quentin-z80/iso-usb2pwrd/README.md

# iso-usb2pwrd

USB-C 2.0 Isolator with 1W Power passthrough

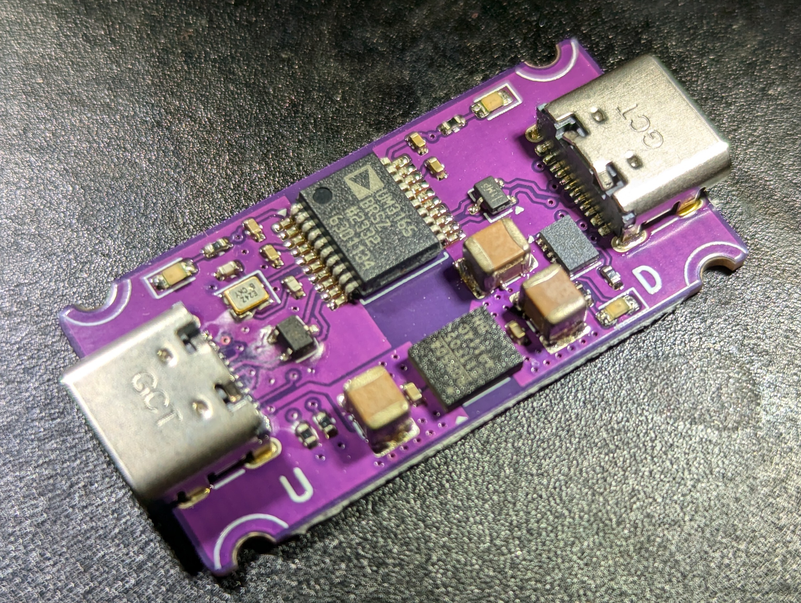
[picture p1: img/front.jpg]


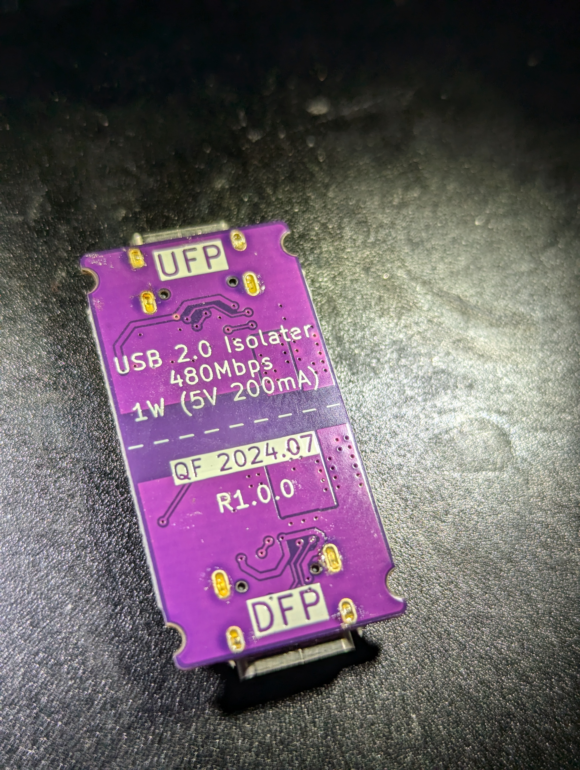
[picture p2: img/back.jpg]
