quentin-z80/iso-usb2pwrd/iso-usb2pwrd.pdf

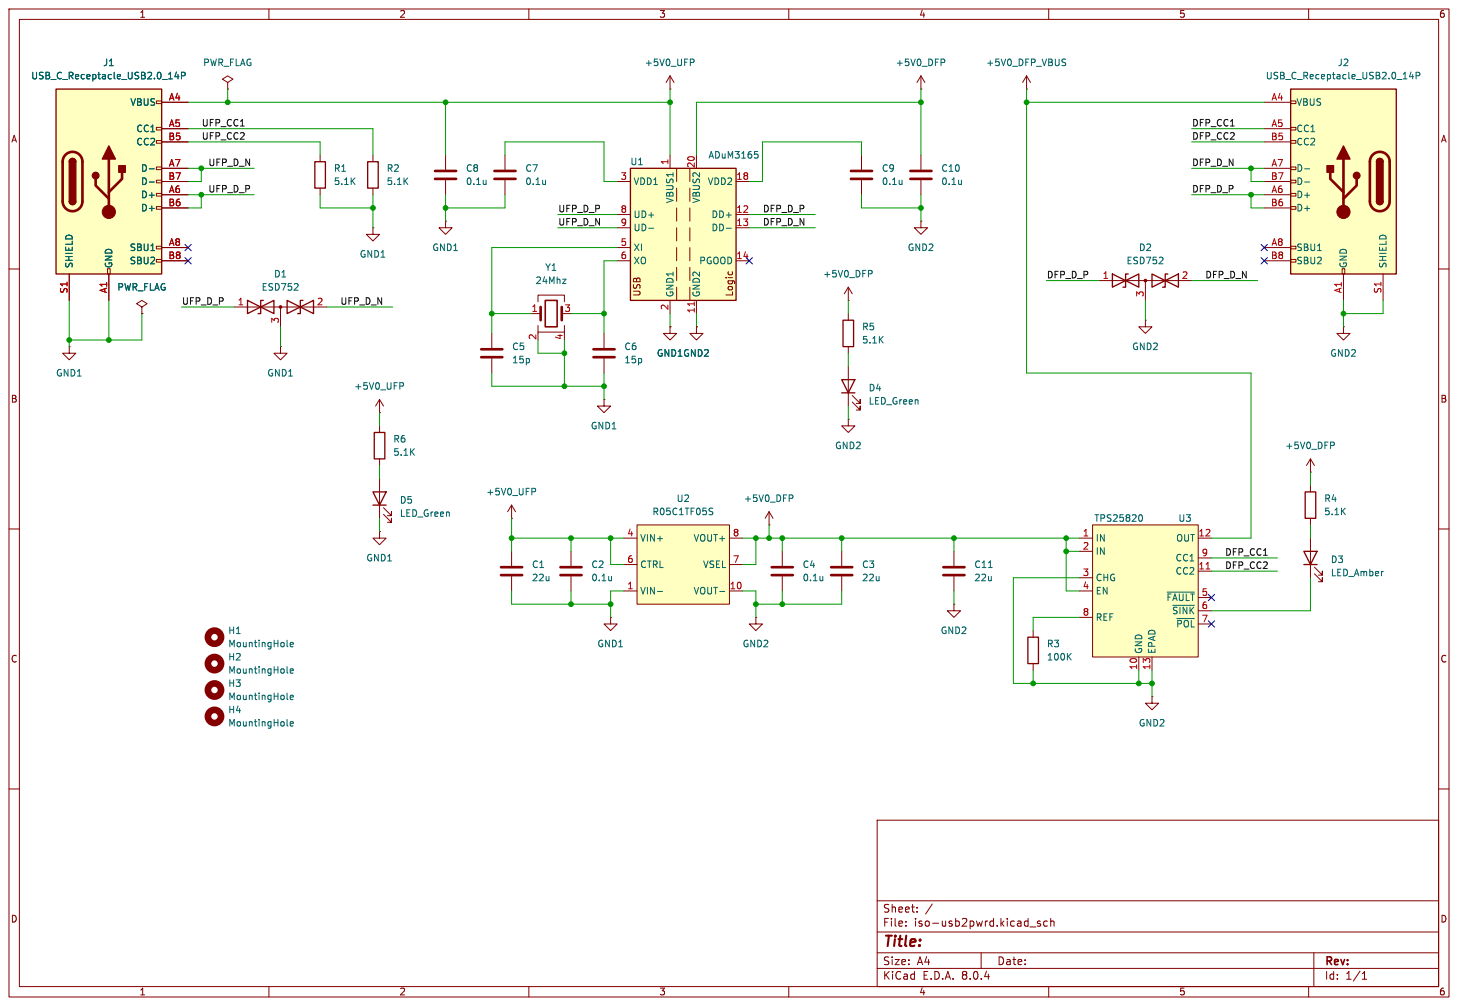
[picture p3: page 1]

2 VBUS2 20 VDD1 3 XI 5 XO 6 UD+ 8 UD- 9 U1 ADuM3165 GND1 C2

Id: 1/1 Title: File: iso-usb2pwrd.kicad_sch Sheet: /
