quentin-z80/iso-usb2pwrd/iso-usb2pwrd.kicad_pcb

## KiCad design iso-usb2pwrd.kicad_pcb (2024-07-22)

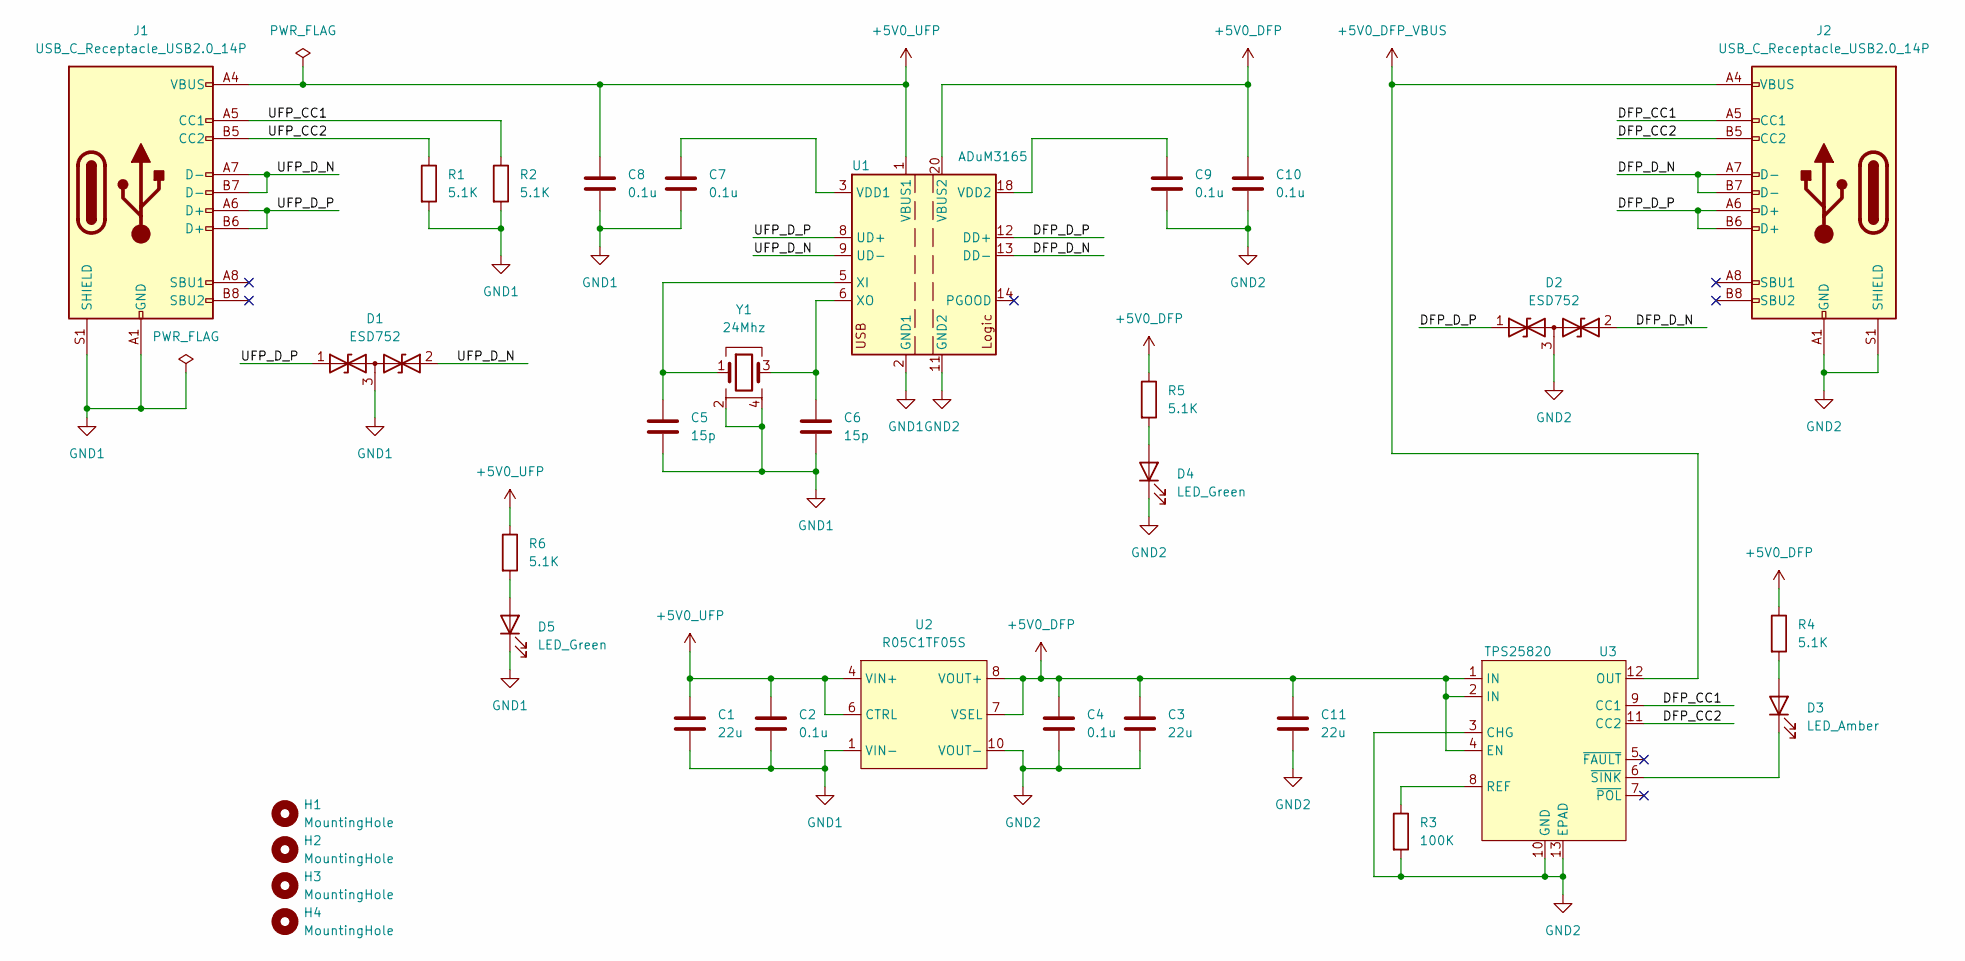
[picture p4: schematic iso-usb2pwrd.kicad_sch]

Parts:
C1, C3, C11: 22u; C_1210_3225Metric; MPN CL32B226MOJNNNE
C2, C4, C7, C8, C9, C10: 0.1u; C_0402_1005Metric; MPN GCM155R71H104KE02D
C5, C6: 15p; C_0402_1005Metric; MPN 0402N150J250CT
D1, D2: ESD752; SOT-323_SC-70; MPN ESD752DCKR
D3: LED_Amber; LED_0603_1608Metric; MPN SML-D12D1WT86
D4, D5: LED_Green; LED_0603_1608Metric; MPN SML-D12M8WT86
H1, H2, H3, H4: MountingHole; MountingHole_2.2mm_M2
J1, J2: USB_C_Receptacle_USB2.0_14P; USB_C_Receptacle_GCT_USB4105-xx-A_16P_TopMnt_Horizontal; MPN USB4105-GF-A
R1, R2, R4, R5, R6: 5.1K; R_0402_1005Metric; MPN RC0402FR-075K1L
R3: 100K; R_0402_1005Metric; MPN RC0402FR-07100KL
U1: ADuM3165; SSOP-20_5.3x7.2mm_P0.65mm; MPN ADUM3165BRSZ-RL
U2: R05C1TF05S; Package_LGA-12_5x4mm; MPN R05C1TF05S-R
U3: TPS25820; WSON-12-1EP_3x2mm_P0.5mm_EP1x2.65_ThermalVias; MPN TPS25820DSSR
Y1: 24Mhz; Crystal_SMD_2016-4Pin_2.0x1.6mm; MPN ECS-240-12-37B-CKY-TR

Connections:
+5V0_DFP: C3.1, C4.1, C10.1, C11.1, R4.1, R5.1, U1.20 (VBUS2), U2.7 (VSEL), U2.8 (VOUT+), U2.9 (VOUT+), U3.1 (IN), U3.2 (IN), U3.4 (EN)
+5V0_DFP_VBUS: J2.A4 (VBUS), J2.A9 (VBUS), J2.B4 (VBUS), J2.B9 (VBUS), U3.12 (OUT)
+5V0_UFP: C1.1, C2.1, C8.1, J1.A4 (VBUS), J1.A9 (VBUS), J1.B4 (VBUS), J1.B9 (VBUS), R6.1, U1.1 (VBUS1), U2.4 (VIN+), U2.5 (VIN+), U2.6 (CTRL)
/DFP_CC1: J2.A5 (CC1), U3.9 (CC1)
/DFP_CC2: J2.B5 (CC2), U3.11 (CC2)
/DFP_D_N: D2.2 (A2), J2.A7 (D-), J2.B7 (D-), U1.13 (DD-)
/DFP_D_P: D2.1 (A1), J2.A6 (D+), J2.B6 (D+), U1.12 (DD+)
/UFP_CC1: J1.A5 (CC1), R2.1
/UFP_CC2: J1.B5 (CC2), R1.1
/UFP_D_N: D1.2 (A2), J1.A7 (D-), J1.B7 (D-), U1.9 (UD-)
/UFP_D_P: D1.1 (A1), J1.A6 (D+), J1.B6 (D+), U1.8 (UD+)
GND1: C1.2, C2.2, C5.2, C6.2, C7.2, C8.2, D1.3 (common), D5.1 (K), J1.A1 (GND), J1.A12 (GND), J1.B1 (GND), J1.B12 (GND), J1.S1 (SHIELD), R1.2, R2.2, U1.2 (GND1), U1.4 (GND1), U1.7 (GND1), U1.10 (GND1), U2.1 (VIN-), U2.2 (VIN-), U2.3 (VIN-), Y1.2, Y1.4
GND2: C3.2, C4.2, C9.2, C10.2, C11.2, D2.3 (common), D4.1 (K), J2.A1 (GND), J2.A12 (GND), J2.B1 (GND), J2.B12 (GND), J2.S1 (SHIELD), R3.2, U1.11 (GND2), U1.15 (GND2), U1.16 (GND2), U1.17 (GND2), U1.19 (GND2), U2.10 (VOUT-), U2.11 (VOUT-), U2.12 (VOUT-), U3.3 (CHG), U3.10 (GND), U3.13 (EPAD)
unnamed: D3.2 (A), R4.2
unnamed: D3.1 (K), U3.6 (~SINK)
unnamed: D4.2 (A), R5.2
unnamed: D5.2 (A), R6.2
unnamed: C7.1, U1.3 (VDD1)
unnamed: C9.1, U1.18 (VDD2)
unnamed: C5.1, U1.5 (XI), Y1.1
unnamed: C6.1, U1.6 (XO), Y1.3
unnamed: R3.1, U3.8 (REF)

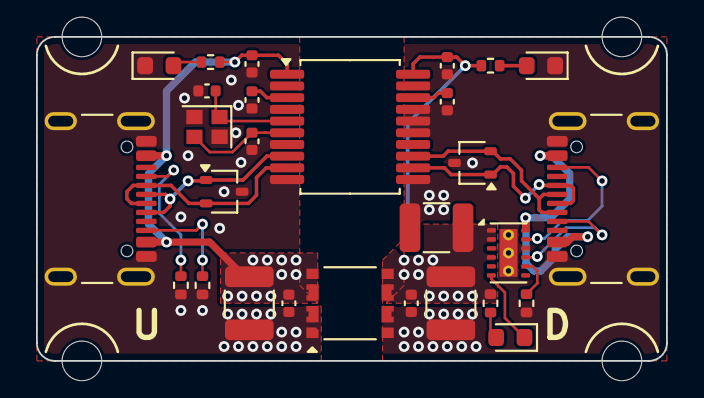
[picture p5: board iso-usb2pwrd.kicad_pcb from above]

Board: 2 copper layers, 35.0 x 18.0 mm, 32 parts (0 on the bottom side), 22 nets.
