quentin-z80/iso-usb2pwrd/(commit log)

2024-07-22 inital commit
    [iso-usb2pwrd.kicad_pcb, iso-usb2pwrd.kicad_sch, iso-usb2pwrd_panel.kicad_pcb]
2024-07-22 update panel config: reduce vspace
    [iso-usb2pwrd_panel.kicad_pcb]
2024-07-22 add board rev
    [iso-usb2pwrd.kicad_pcb, iso-usb2pwrd.kicad_sch, iso-usb2pwrd_panel.kicad_pcb]
2024-08-09 add images of board
